cgdailly/Electronic_Pachinko_Machine-Spring_2026/IMG_9378.jpg

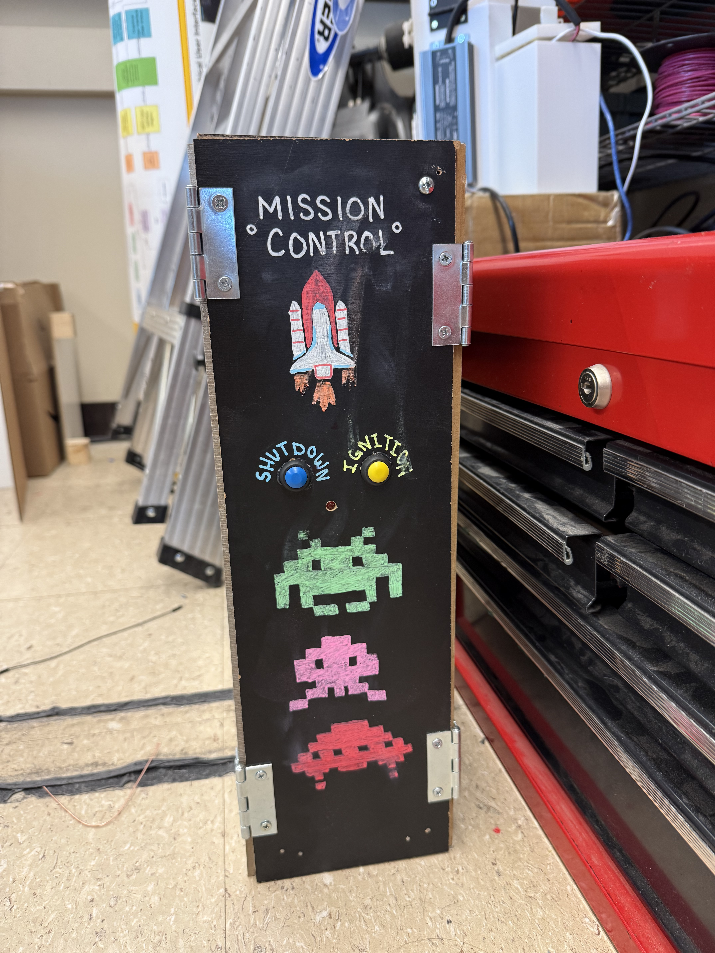
[picture p2: IMG_9378.jpg]
IMG_9378.jpg
