cgdailly/Electronic_Pachinko_Machine-Spring_2026/IMG_9379.jpg

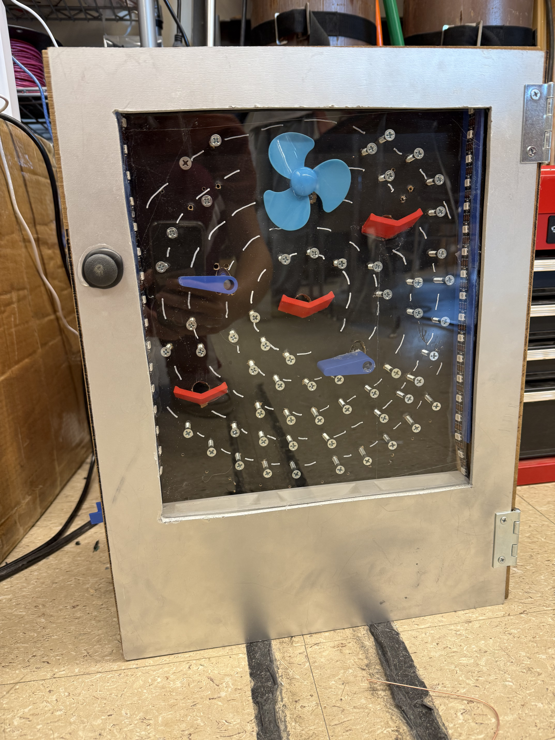
[picture p3: IMG_9379.jpg]
IMG_9379.jpg
