cgdailly/Electronic_Pachinko_Machine-Spring_2026/IMG_9380.jpg

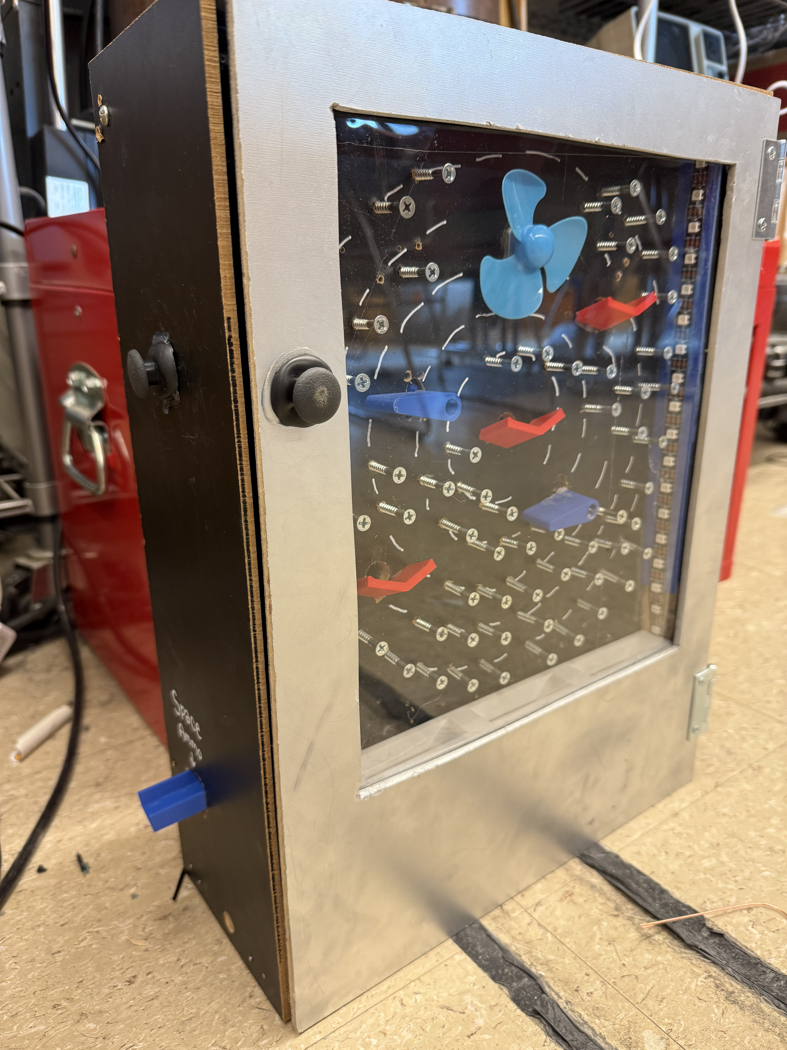
[picture p4: IMG_9380.jpg]
IMG_9380.jpg
