cgdailly/Electronic_Pachinko_Machine-Spring_2026/IMG_9381.jpg

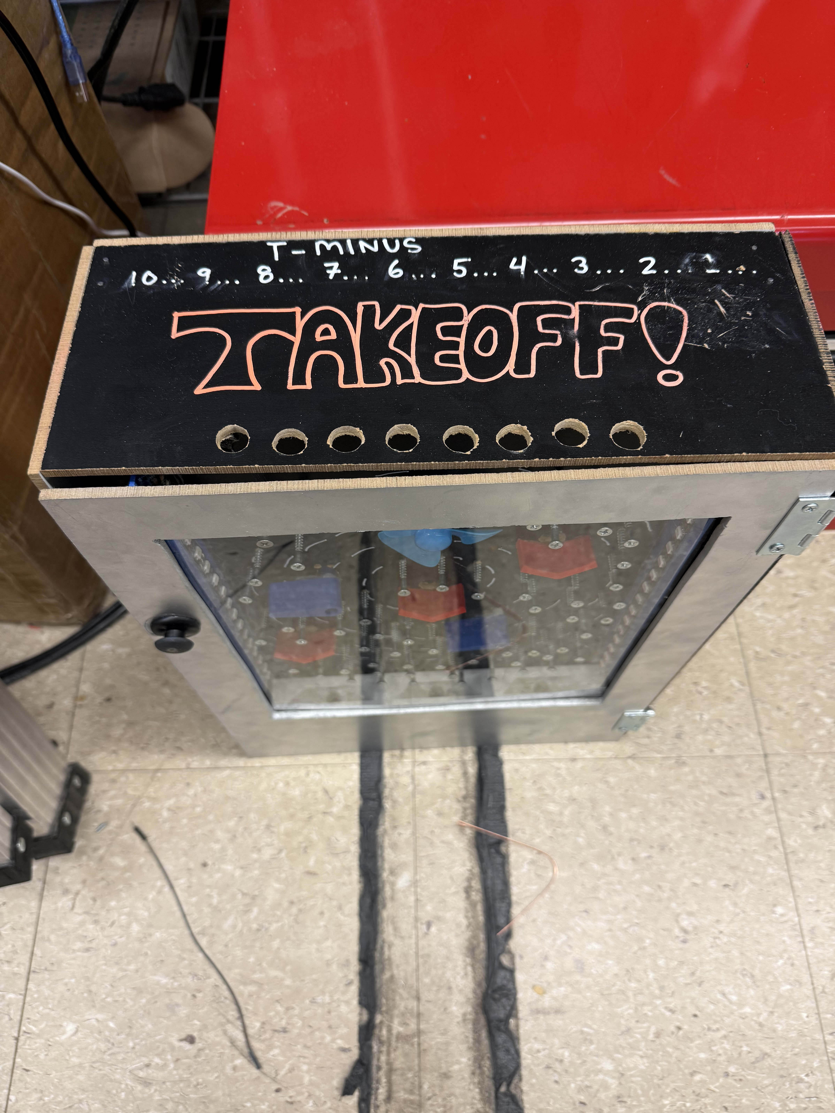
[picture p5: IMG_9381.jpg]
IMG_9381.jpg
